TomKeddie/prj-ft2232-breakout/ft2232-breakout.kicad_pcb

## KiCad design ft2232-breakout.kicad_pcb (2022-10-12)

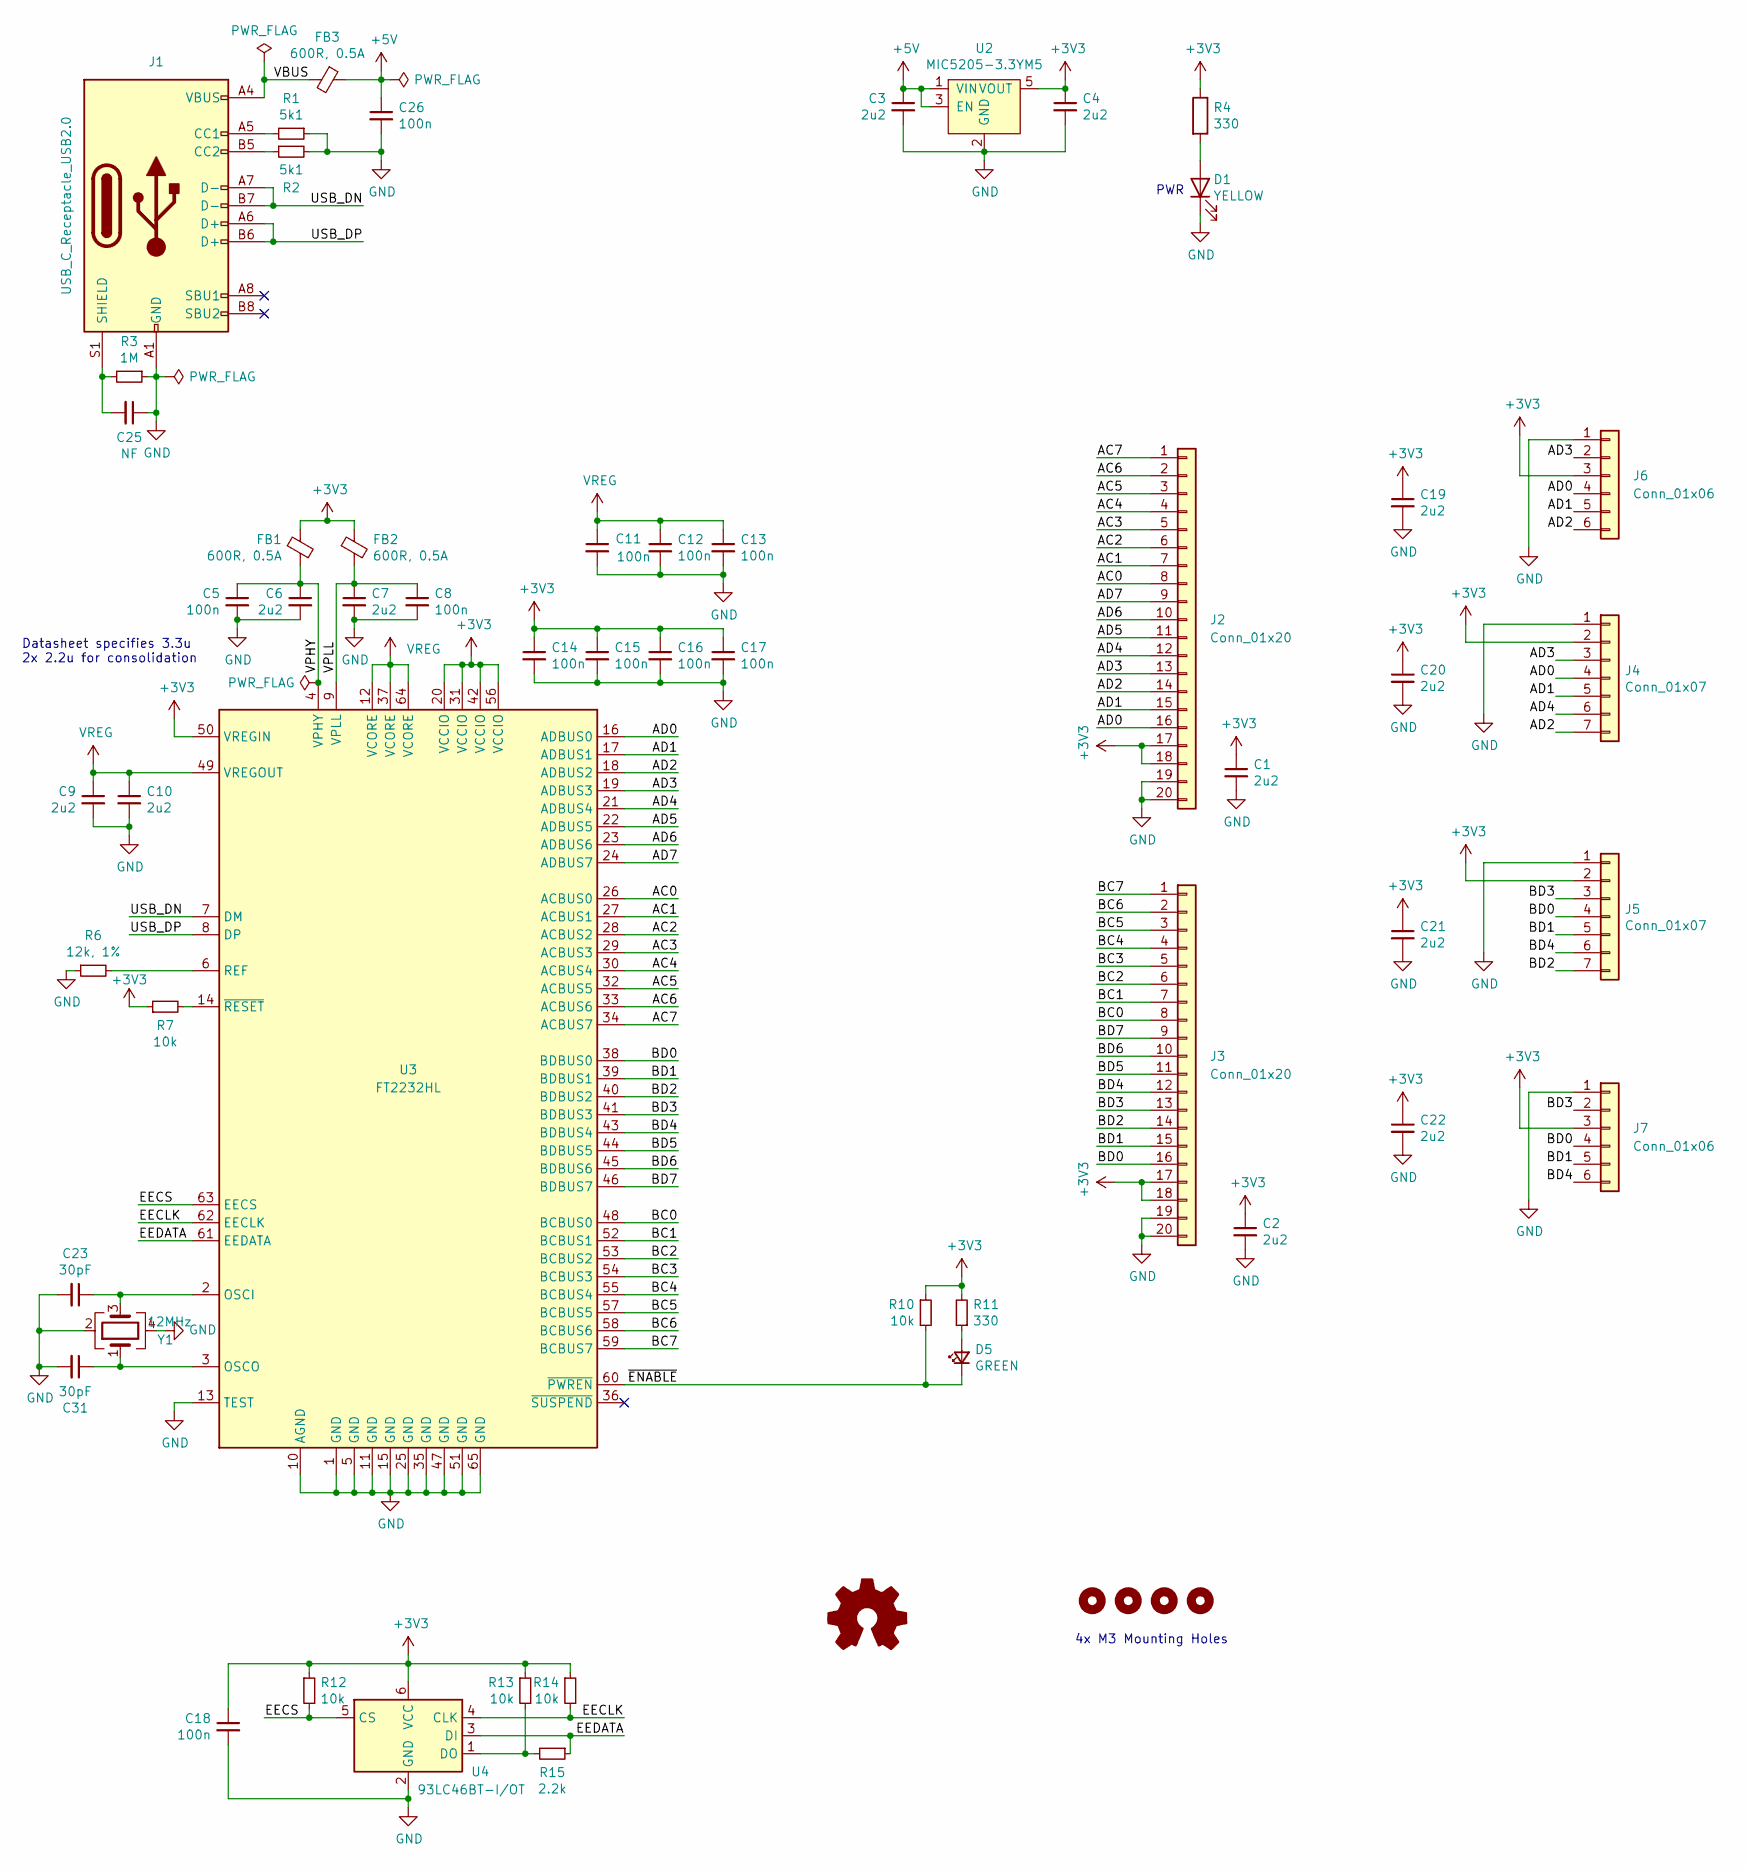
[picture p1: schematic ft2232-breakout.kicad_sch, Tigard]

Parts:
C1, C2, C3, C4, C6, C7, C9, C10, C19, C20, C21, C22: 2u2; C_0805_2012Metric; LCSC C307419
C5, C8, C11, C12, C13, C14, C15, C16, C17, C18, C26: 100n; C_0805_2012Metric; LCSC C100072
C23, C31: 30pF; C_0805_2012Metric; LCSC C159804
C25: NF; C_0805_2012Metric
D1: YELLOW; LED_0805_2012Metric; LCSC C160477
D5: GREEN; LED_0805_2012Metric; LCSC C12065
FB1, FB2, FB3: 600R, 0.5A; L_0805_2012Metric; LCSC C76886
H1, H2, H3, H4: MountingHole; MountingHole_3.2mm_M3_ISO7380
J1: USB_C_Receptacle_USB2.0; USB_C_Receptacle_HRO_TYPE-C-31-M-12; LCSC C165948
J2, J3: Conn_01x20; PinHeader_1x20_P2.54mm_Horizontal
J4, J5: Conn_01x07; PinHeader_1x07_P2.54mm_Horizontal
J6, J7: Conn_01x06; PinHeader_1x06_P2.54mm_Horizontal
LOGO1: Logo_Open_Hardware_Small; OSHW-Symbol_4.4x4mm_SilkScreen
R1, R2: 5k1; L_0805_2012Metric; LCSC C25941
R3: 1M; L_0805_2012Metric; LCSC C26087
R4, R11: 330; L_0805_2012Metric; LCSC C25104
R6: 12k, 1%; L_0805_2012Metric; LCSC C25752
R7, R10, R12, R13, R14: 10k; L_0805_2012Metric; LCSC C301923
R15: 2.2k; L_0805_2012Metric; LCSC C25879
U2: MIC5205-3.3YM5; SOT-23-5_RoundRect; LCSC C150742
U3: FT2232HL; LQFP-64_10x10mm_P0.5mm; LCSC C193662
U4: 93LC46BT-I/OT; SOT-23-6_RoundRect; LCSC C190271
Y1: 12MHz; Crystal_SMD_3225-4Pin_3.2x2.5mm_RoundRect; LCSC C9002

Connections:
+3V3: C1.1, C2.1, C4.1, C14.1, C15.1, C16.1, C17.1, C18.1, C19.1, C20.1, C21.1, C22.1, FB1.1, FB2.1, J2.17, J2.18, J3.17, J3.18, J4.2, J5.2, J6.3, J7.3, R4.1, R7.1, R10.1, R11.2, R12.1, R13.1, R14.1, U2.5 (VOUT), U3.20 (VCCIO), U3.31 (VCCIO), U3.42 (VCCIO), U3.50 (VREGIN), U3.56 (VCCIO), U4.6 (VCC)
+5V: C3.1, C26.1, FB3.1, U2.1 (VIN), U2.3 (EN)
/AC0: J2.8, U3.26 (ACBUS0)
/AC1: J2.7, U3.27 (ACBUS1)
/AC2: J2.6, U3.28 (ACBUS2)
/AC3: J2.5, U3.29 (ACBUS3)
/AC4: J2.4, U3.30 (ACBUS4)
/AC5: J2.3, U3.32 (ACBUS5)
/AC6: J2.2, U3.33 (ACBUS6)
/AC7: J2.1, U3.34 (ACBUS7)
/AD0: J2.16, J4.4, J6.4, U3.16 (ADBUS0)
/AD1: J2.15, J4.5, J6.5, U3.17 (ADBUS1)
/AD2: J2.14, J4.7, J6.6, U3.18 (ADBUS2)
/AD3: J2.13, J4.3, J6.2, U3.19 (ADBUS3)
/AD4: J2.12, J4.6, U3.21 (ADBUS4)
/AD5: J2.11, U3.22 (ADBUS5)
/AD6: J2.10, U3.23 (ADBUS6)
/AD7: J2.9, U3.24 (ADBUS7)
/BC0: J3.8, U3.48 (BCBUS0)
/BC1: J3.7, U3.52 (BCBUS1)
/BC2: J3.6, U3.53 (BCBUS2)
/BC3: J3.5, U3.54 (BCBUS3)
/BC4: J3.4, U3.55 (BCBUS4)
/BC5: J3.3, U3.57 (BCBUS5)
/BC6: J3.2, U3.58 (BCBUS6)
/BC7: J3.1, U3.59 (BCBUS7)
/BD0: J3.16, J5.4, J7.4, U3.38 (BDBUS0)
/BD1: J3.15, J5.5, J7.5, U3.39 (BDBUS1)
/BD2: J3.14, J5.7, U3.40 (BDBUS2)
/BD3: J3.13, J5.3, J7.2, U3.41 (BDBUS3)
/BD4: J3.12, J5.6, J7.6, U3.43 (BDBUS4)
/BD5: J3.11, U3.44 (BDBUS5)
/BD6: J3.10, U3.45 (BDBUS6)
/BD7: J3.9, U3.46 (BDBUS7)
/EECLK: R14.2, U3.62 (EECLK), U4.4 (CLK)
/EECS: R12.2, U3.63 (EECS), U4.5 (CS)
/EEDATA: R15.1, U3.61 (EEDATA), U4.3 (DI)
/USB_DN: J1.A7 (D-), J1.B7 (D-), U3.7 (DM)
/USB_DP: J1.A6 (D+), J1.B6 (D+), U3.8 (DP)
/VBUS: FB3.2, J1.A4 (VBUS), J1.A9 (VBUS), J1.B4 (VBUS), J1.B9 (VBUS)
/VPHY: C5.1, C6.1, FB1.2, U3.4 (VPHY)
/VPLL: C7.1, C8.1, FB2.2, U3.9 (VPLL)
/~ENABLE: D5.1 (K), R10.2, U3.60 (~PWREN)
GND: C1.2, C2.2, C3.2, C4.2, C5.2, C6.2, C7.2, C8.2, C9.2, C10.2, C11.2, C12.2, C13.2, C14.2, C15.2, C16.2, C17.2, C18.2, C19.2, C20.2, C21.2, C22.2, C23.2, C25.1, C26.2, C31.2, D1.1 (K), J1.A1 (GND), J1.A12 (GND), J1.B1 (GND), J1.B12 (GND), J2.19, J2.20, J3.19, J3.20, J4.1, J5.1, J6.1, J7.1, R1.1, R2.2, R3.1, R6.1, U2.2 (GND), U3.1 (GND), U3.5 (GND), U3.10 (AGND), U3.11 (GND), U3.13 (TEST), U3.15 (GND), U3.25 (GND), U3.35 (GND), U3.47 (GND), U3.51 (GND), U3.65 (GND), U4.2 (GND), Y1.2, Y1.4
unnamed: C23.1, U3.2 (OSCI), Y1.3
unnamed: C25.2, J1.S1 (SHIELD), R3.2
unnamed: C31.1, U3.3 (OSCO), Y1.1
unnamed: D1.2 (A), R4.2
unnamed: D5.2 (A), R11.1
unnamed: J1.A5 (CC1), R1.2
unnamed: J1.B5 (CC2), R2.1
unnamed: R6.2, U3.6 (REF)
unnamed: R7.2, U3.14 (~RESET)
unnamed: R13.2, R15.2, U4.1 (DO)
VREG: C9.1, C10.1, C11.1, C12.1, C13.1, U3.12 (VCORE), U3.37 (VCORE), U3.49 (VREGOUT), U3.64 (VCORE)

Notes on the sheet:
PWR
Datasheet specifies 3.3u 2x 2.2u for consolidation
4x M3 Mounting Holes

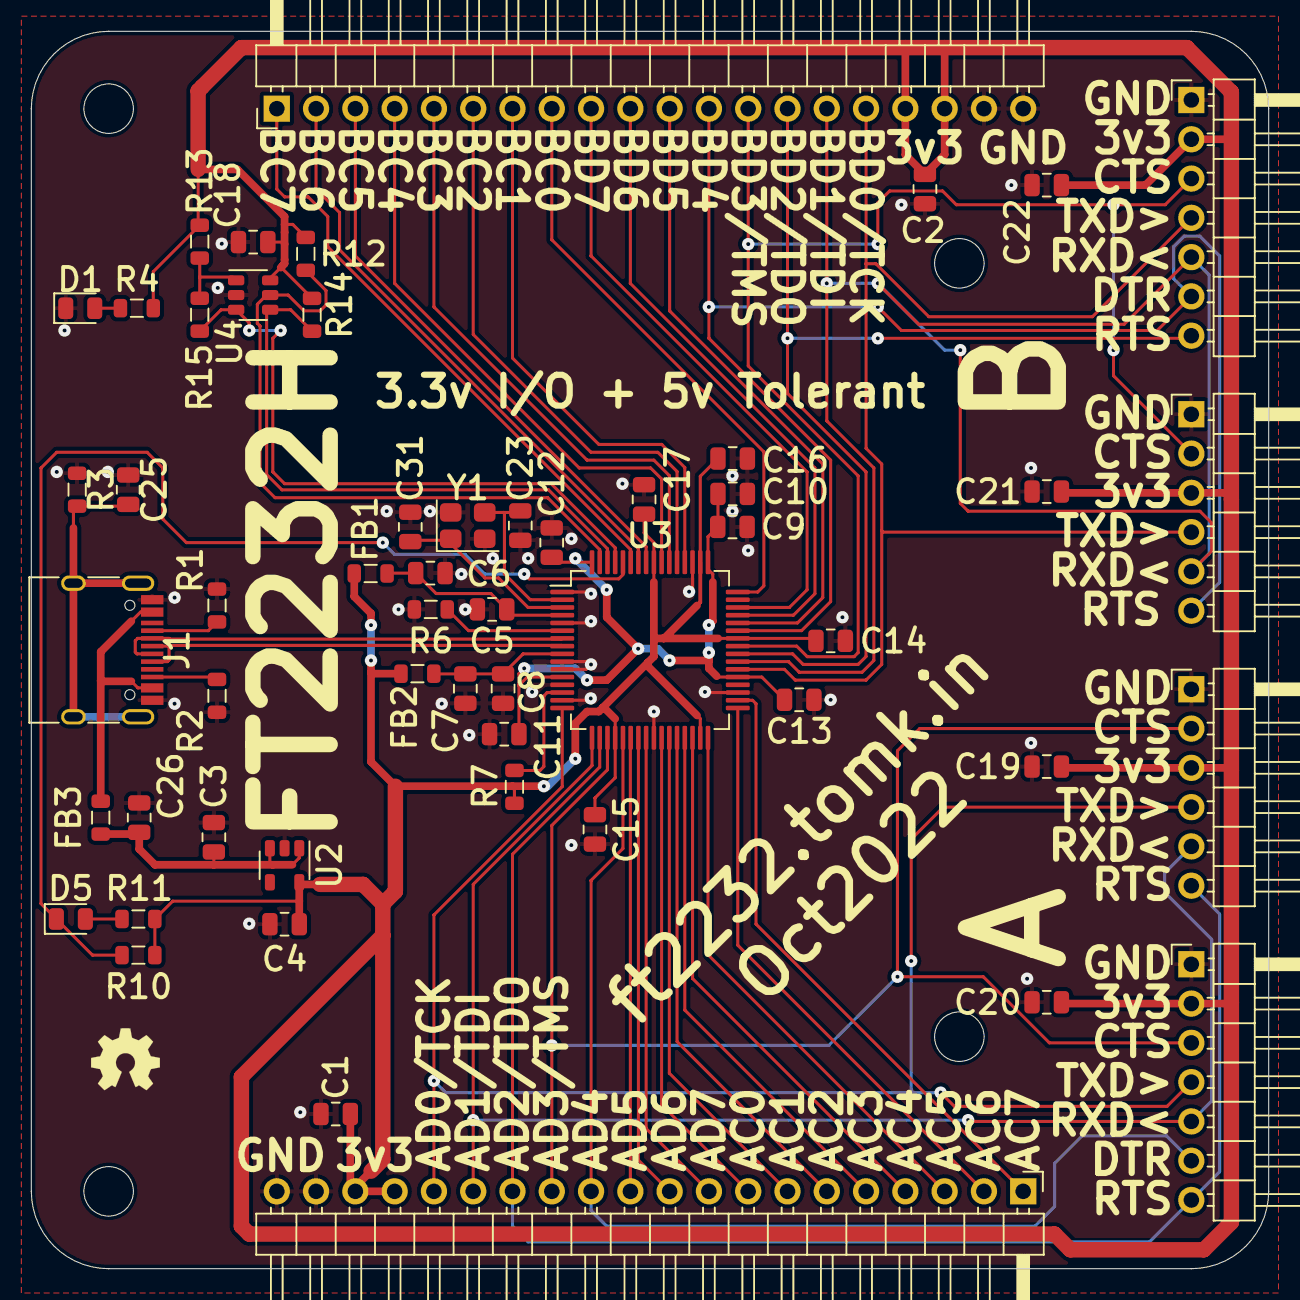
[picture p2: board ft2232-breakout.kicad_pcb from above]

Board: 2 copper layers, 80.0 x 80.0 mm, 59 parts (0 on the bottom side), 55 nets.
