TomKeddie/prj-ft2232-breakout/(commit log)

2022-10-12 As sent to jlcpcb 2022-10-12a
    [ft2232-breakout.kicad_pcb, ft2232-breakout.kicad_sch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]
2022-12-15 Oct2022 as manufactured
    [eeprom.cfg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]
