TomKeddie/prj-ft2232-breakout/(notices)

Notices in the files:
ft2232-breakout.kicad_sch:
Copyright 2020 Franklin Harding
Licensed under CC-BY-SA 4.0
